stefan-misik/test-board/README.md

# test-board
Simple development board with interface to Nokia 5110 display and matrix keypad and two outputs based on Atmega328 microcontroller
