stefan-misik/test-board/HW/KiCad/ts.kicad_pcb

## KiCad design HW/KiCad/ts.kicad_pcb (2020-12-20)

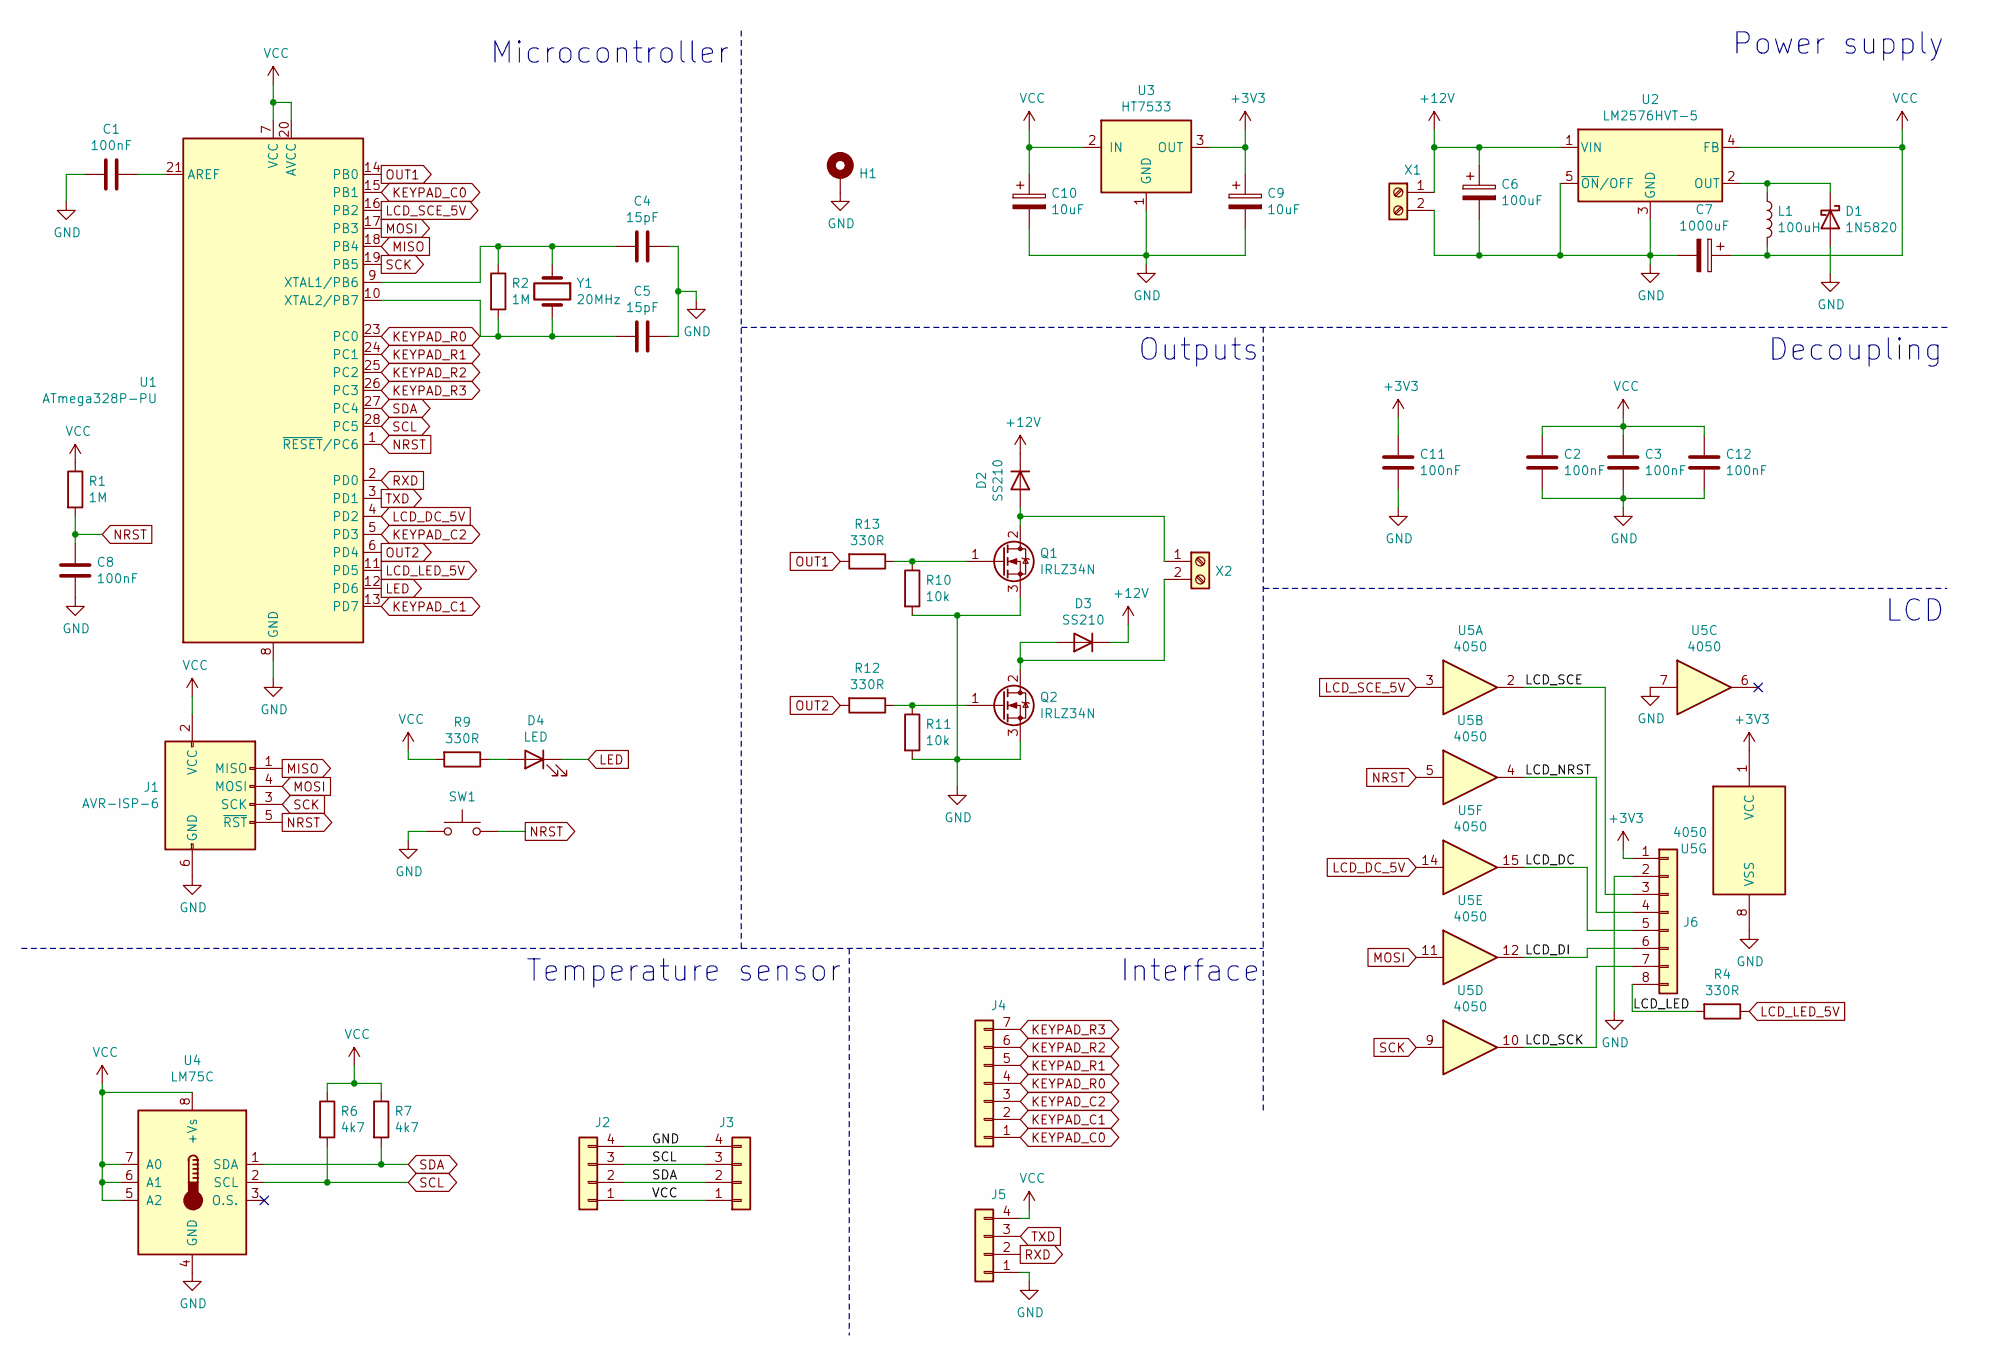
[picture p1: schematic ts.sch, TS board]

Parts:
C1, C2, C3, C8, C11, C12: 100nF; C_0805_2012Metric
C4, C5: 15pF; C_0805_2012Metric
C6: 100uF; CP_Radial_D8.0mm_P3.80mm
C7: 1000uF; CP_Radial_D10.0mm_P5.00mm
C9, C10: 10uF; CP_Elec_5x5.4
D1: 1N5820; D_DO-201AD_P15.24mm_Horizontal
D2, D3: SS210; D_SMB
D4: LED; LED_D5.0mm
H1: MountingHole_Pad; MountingHole_3.5mm_Pad
J1: AVR-ISP-6; PinHeader_2x03_P2.54mm_Vertical
J2, J3, J5: Conn_01x04; PinHeader_1x04_P2.54mm_Vertical
J4: Conn_01x07; PinHeader_1x07_P2.54mm_Vertical
J6: Conn_01x08; PinHeader_1x08_P2.54mm_Vertical
L1: 100uH; L_Toroid_Vertical_L16.4mm_W7.6mm_P6.60mm_Vishay_TJ3
Q1, Q2: IRLZ34N; TO-220-3_Vertical
R1, R2: 1M; R_0805_2012Metric
R4, R9, R12, R13: 330R; R_0805_2012Metric
R6, R7: 4k7; R_0805_2012Metric
R10, R11: 10k; R_0805_2012Metric
SW1: RESET; SW_PUSH_6mm
U1: ATmega328P-PU; DIP-28_W7.62mm_Socket
U2: LM2576HVT-5; TO-220-5_Vertical
U3: HT7533; TO-92
U4: LM75C; SOIC-8_3.9x4.9mm_P1.27mm
U5: 4050; SOIC-16_3.9x9.9mm_P1.27mm
X1, X2: Screw_Terminal_01x02; TerminalBlock_bornier-2_P5.08mm
Y1: 20MHz; Crystal_HC49-4H_Vertical

Connections:
+3V3: C9.1, C11.1, J6.1, U3.3 (OUT), U5.1 (VCC)
+12V: C6.1, D2.1 (K), D3.1 (K), U2.1 (VIN), X1.1
/LCD_DC: J6.5, U5.15
/LCD_DI: J6.6, U5.12
/LCD_LED: J6.8, R4.2
/LCD_NRST: J6.4, U5.4
/LCD_SCE: J6.3, U5.2
/LCD_SCK: J6.7, U5.10
GND: C1.2, C2.2, C3.2, C4.1, C5.1, C6.2, C7.2, C8.1, C9.2, C10.2, C11.2, C12.2, D1.2 (A), H1.1, J1.6 (GND), J2.4, J3.4, J5.1, J6.2, Q1.3 (S), Q2.3 (S), R10.2, R11.2, SW1.1, U1.8 (GND), U1.22 (GND), U2.3 (GND), U2.5 (~ON~/OFF), U3.1 (GND), U4.4 (GND), U5.7, U5.8 (VSS), X1.2
KEYPAD_C0: J4.1, U1.15 (PB1)
KEYPAD_C1: J4.2, U1.13 (PD7)
KEYPAD_C2: J4.3, U1.5 (PD3)
KEYPAD_R0: J4.4, U1.23 (PC0)
KEYPAD_R1: J4.5, U1.24 (PC1)
KEYPAD_R2: J4.6, U1.25 (PC2)
KEYPAD_R3: J4.7, U1.26 (PC3)
LCD_DC_5V: U1.4 (PD2), U5.14
LCD_LED_5V: R4.1, U1.11 (PD5)
LCD_SCE_5V: U1.16 (PB2), U5.3
LED: D4.1 (K), U1.12 (PD6)
MISO: J1.1 (MISO), U1.18 (PB4)
MOSI: J1.4 (MOSI), U1.17 (PB3), U5.11
NRST: C8.2, J1.5 (~RST), R1.2, SW1.2, U1.1 (~RESET~/PC6), U5.5
unnamed: C1.1, U1.21 (AREF)
unnamed: C4.2, R2.1, U1.9 (XTAL1/PB6), Y1.1
unnamed: C5.2, R2.2, U1.10 (XTAL2/PB7), Y1.2
unnamed: D1.1 (K), L1.1, U2.2 (OUT)
unnamed: D2.2 (A), Q1.2 (D), X2.1
unnamed: D3.2 (A), Q2.2 (D), X2.2
unnamed: D4.2 (A), R9.1
unnamed: Q1.1 (G), R10.1, R13.1
unnamed: Q2.1 (G), R11.1, R12.1
OUT1: R13.2, U1.14 (PB0)
OUT2: R12.2, U1.6 (PD4)
RXD: J5.2, U1.2 (PD0)
SCK: J1.3 (SCK), U1.19 (PB5), U5.9
SCL: J2.3, J3.3, R6.2, U1.28 (PC5), U4.2 (SCL)
SDA: J2.2, J3.2, R7.2, U1.27 (PC4), U4.1 (SDA)
TXD: J5.3, U1.3 (PD1)
VCC: C2.1, C3.1, C7.1, C10.1, C12.1, J1.2 (VCC), J2.1, J3.1, J5.4, L1.2, R1.1, R6.1, R7.1, R9.2, U1.7 (VCC), U1.20 (AVCC), U2.4 (FB), U3.2 (IN), U4.5 (A2), U4.6 (A1), U4.7 (A0), U4.8 (+Vs)

Notes on the sheet:
Temperature sensor
Interface
Microcontroller
Power supply
Decoupling
LCD
Outputs

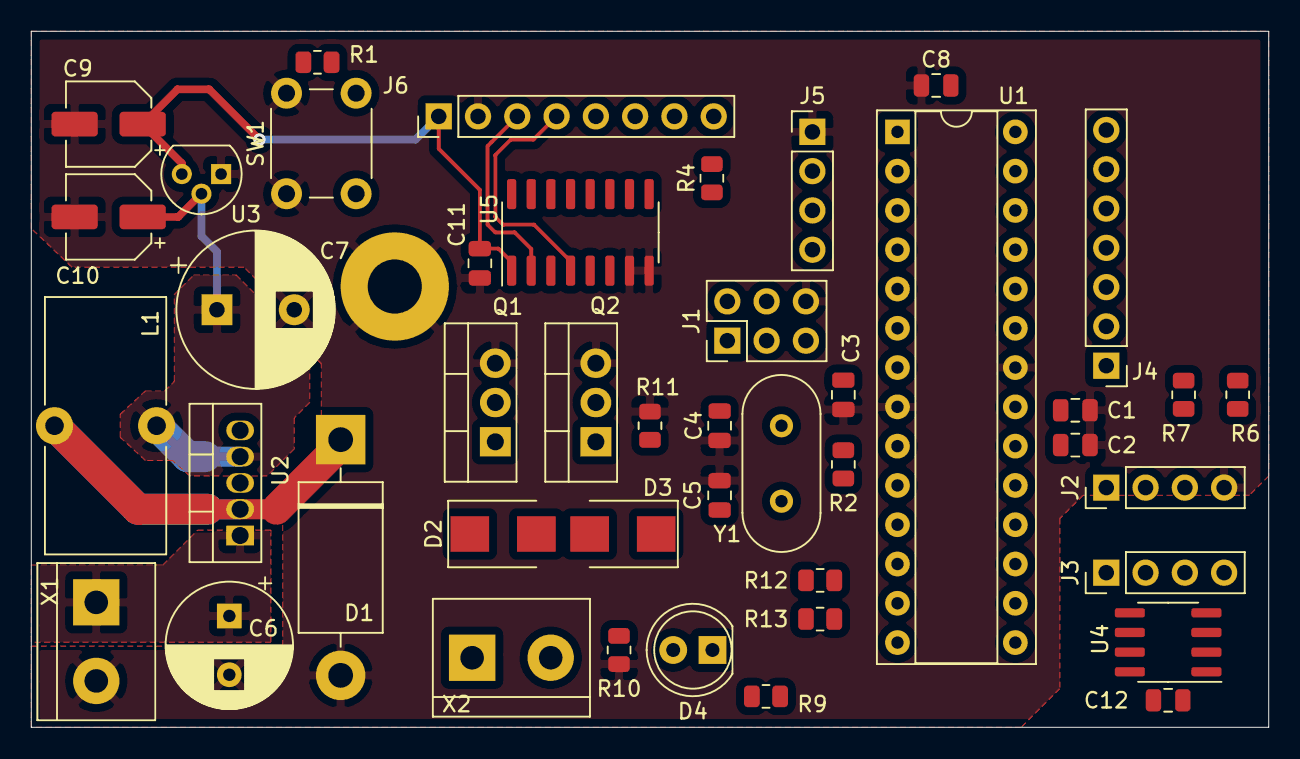
[picture p2: board ts.kicad_pcb from above]

Board: 2 copper layers, 80.0 x 45.0 mm, 45 parts (0 on the bottom side), 40 nets.
