stefan-misik/test-board/HW/Eagle/projects/ts/main.brd

## EAGLE design HW/Eagle/projects/ts/main.brd (2018-11-20)

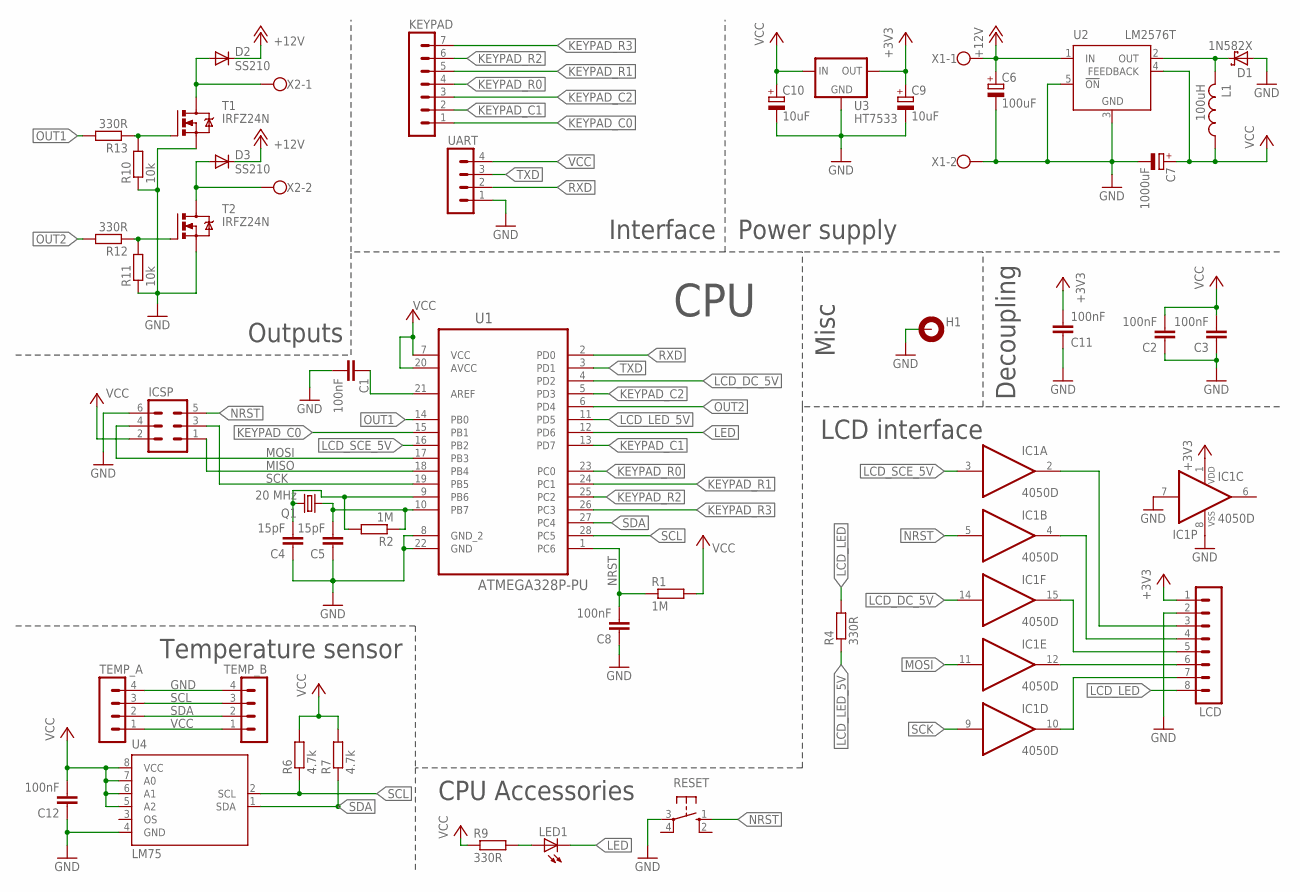
[picture p3: schematic main.sch]

Parts:
C1, C2, C3, C8, C11, C12: 100nF; C0805
C4, C5: 15pF; C0805
C6: 100uF; TAP5-80
C7: 1000uF; TT5D10
C9, C10: 10uF; PANASONIC_C
D1: 1N582X; DIODE5MM
D2, D3: SS210; SMB
H1: MOUNT-PAD-ROUND3.6; 3,6-PAD
IC1: 4050D; SO16
ICSP: MA03-2
KEYPAD: MA07-1
L1: 100uH; TJ3-U1
LCD: MA08-1
LED1: LED5MM
Q1: 20 MHz; HC49/S
R1, R2: 1M; R0805
R4, R9, R12, R13: 330R; R0805
R6, R7: 4.7k; R0805
R10, R11: 10k; R0805
RESET: 10-XX; B3F-10XX
T1, T2: IRFZ24N; TO220AB
TEMP_A: MA04-1
TEMP_B: MA04-1
U1: ATMEGA328P-PU; DIP254P762X457-28
U2: LM2576T; TO220-5
U3: HT7533; TO-92
U4: LM75; SOIC8
UART: MA04-1
X1, X2: W237-102

Connections:
+3V3: C9.+, C11.2, IC1.1 (VDD), LCD.1, U3.3 (OUT)
+12V: C6.+, D2.C, D3.C, U2.1 (IN), X1.1
GND: C1.2, C2.1, C3.1, C4.1, C5.1, C6.-, C7.-, C8.1, C9.-, C10.-, C11.1, C12.1, D1.A, H1.B3,6, IC1.7 (I), IC1.8 (VSS), ICSP.6, LCD.2, R10.1, R11.1, RESET.3, T1.S, T2.S, TEMP_A.4, TEMP_B.4, U1.8 (GND_2), U1.22 (GND), U2.3 (GND), U2.5 (!ON), U3.1 (GND), U4.4 (GND), UART.1, X1.2
KEYPAD_C0: KEYPAD.1, U1.15 (PB1)
KEYPAD_C1: KEYPAD.2, U1.13 (PD7)
KEYPAD_C2: KEYPAD.3, U1.5 (PD3)
KEYPAD_R0: KEYPAD.4, U1.23 (PC0)
KEYPAD_R1: KEYPAD.5, U1.24 (PC1)
KEYPAD_R2: KEYPAD.6, U1.25 (PC2)
KEYPAD_R3: KEYPAD.7, U1.26 (PC3)
LCD_DC: IC1.15 (O), LCD.5
LCD_DC_5V: IC1.14 (I), U1.4 (PD2)
LCD_LED: LCD.8, R4.2
LCD_LED_5V: R4.1, U1.11 (PD5)
LCD_MOSI: IC1.12 (O), LCD.6
LCD_RST: IC1.4 (O), LCD.4
LCD_SCE: IC1.2 (O), LCD.3
LCD_SCE_5V: IC1.3 (I), U1.16 (PB2)
LCD_SCK: IC1.10 (O), LCD.7
LED: LED1.K (C), U1.12 (PD6)
MISO: ICSP.1, U1.18 (PB4)
MOSI: IC1.11 (I), ICSP.4, U1.17 (PB3)
unnamed: C1.1, U1.21 (AREF)
unnamed: C5.2, Q1.1, R2.1, U1.10 (PB7)
unnamed: C4.2, Q1.2, R2.2, U1.9 (PB6)
unnamed: LED1.A, R9.2
unnamed: R10.2, R13.1, T1.G
unnamed: R11.2, R12.1, T2.G
NRST: C8.2, IC1.5 (I), ICSP.5, R1.1, RESET.1 (S), U1.1 (PC6)
OUT1: R13.2, U1.14 (PB0)
OUT1_OC: D2.A, T1.D, X2.1
OUT2: R12.2, U1.6 (PD4)
OUT2_OC: D3.A, T2.D, X2.2
OUT_5V: D1.C, L1.2, U2.2 (OUT)
RXD: U1.2 (PD0), UART.2
SCK: IC1.9 (I), ICSP.3, U1.19 (PB5)
SCL: R6.1, TEMP_A.3, TEMP_B.3, U1.28 (PC5), U4.2 (SCL)
SDA: R7.1, TEMP_A.2, TEMP_B.2, U1.27 (PC4), U4.1 (SDA)
TXD: U1.3 (PD1), UART.3
VCC: C2.2, C3.2, C7.+, C10.+, C12.2, ICSP.2, L1.1, R1.2, R6.2, R7.2, R9.1, TEMP_A.1, TEMP_B.1, U1.7 (VCC), U1.20 (AVCC), U2.4 (FEEDBACK), U3.2 (IN), U4.5 (A2), U4.6 (A1), U4.7 (A0), U4.8 (VCC), UART.4

Notes on the sheet:
Outputs
Temperature sensor
LCD interface
Power supply
Interface
CPU Accessories
Decoupling
Misc
CPU

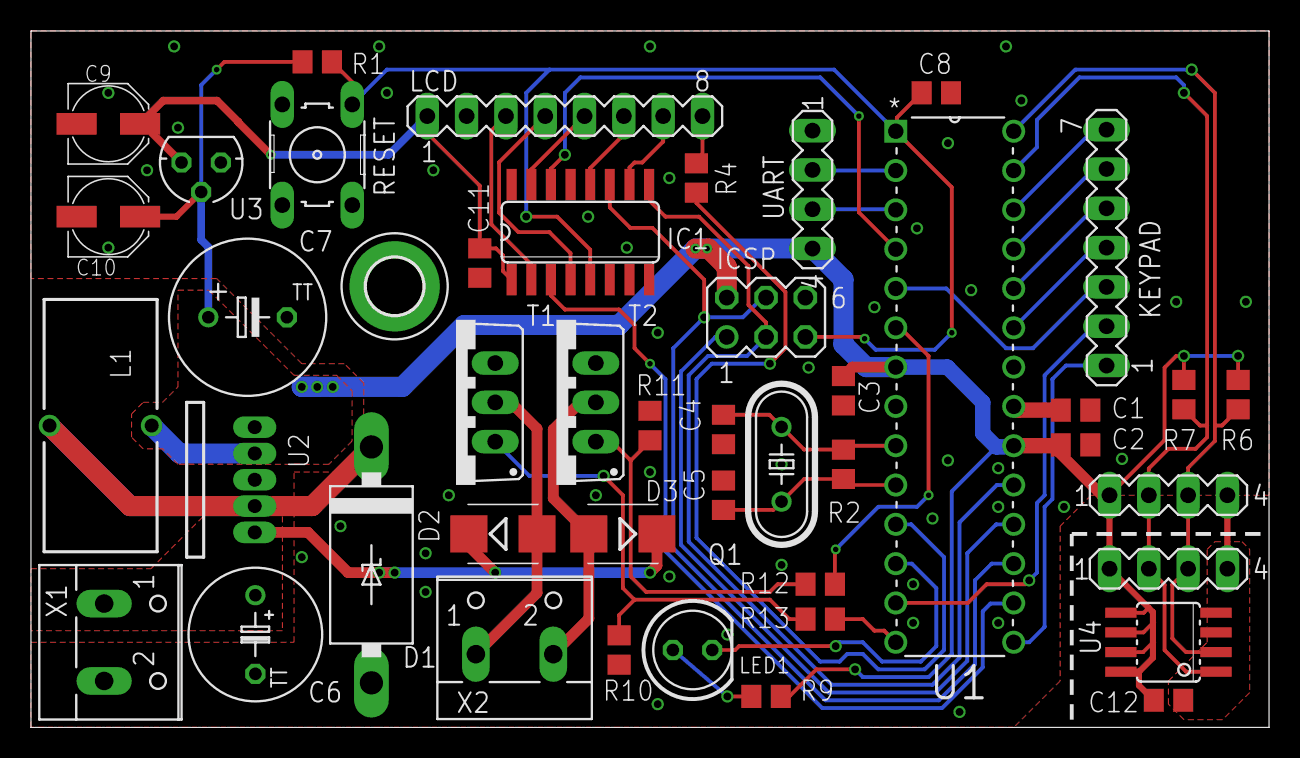
[picture p4: board main.brd from above]

Board: 2 copper layers, 80.0 x 45.0 mm, 45 parts (0 on the bottom side), 40 nets.
