stefan-misik/test-board/SW/embedded/lcd.c

/**
 * \file    lcd.c
 * \author  Stefan Misik
 * \brief   Driver for the LCD
 *     
 */

#include "common.h"
#include "lcd.h"
#include <util/delay.h>
#include <avr/pgmspace.h>
#include <stdio.h>

/**
 * \brief Set lcd mode to DATA
 */
#define lcd_set_d()            PORTD |= (1 << PORTD2)

/**
 * \brief Set lcd mode to COMMAND
 */
#define lcd_set_c()            PORTD &= ~(1 << PORTD2)

/**
 * \brief Set lcd SCE
 */
#define lcd_set_sce(val)    (val) ? (PORTB |= (1 << PORTB2)) : (PORTB &= ~(1 << PORTB2))

/**
 * \brief Macro to calculate display position from coordinates
 */
#define lcd_make_pos(col, row)    ((col) + (84 * (row)))

/**
 * \brief Position on the display 
 */
static unsigned int lcd_pos;


#if LCD_USE_BUFFER == 1

/**
 * \brief Image on the display
 */
unsigned char lcd_buffer[504];

#endif

/**
 * \brief Font
 */
static const unsigned char lcd_ascii[][5] PROGMEM =
{
    {0x00, 0x00, 0x00, 0x00, 0x00}, /* 20   */
    {0x00, 0x00, 0x5f, 0x00, 0x00}, /* 21 ! */
    {0x00, 0x07, 0x00, 0x07, 0x00}, /* 22 " */
    {0x14, 0x7f, 0x14, 0x7f, 0x14}, /* 23 # */
    {0x24, 0x2a, 0x7f, 0x2a, 0x12}, /* 24 $ */
    {0x23, 0x13, 0x08, 0x64, 0x62}, /* 25 % */
    {0x36, 0x49, 0x55, 0x22, 0x50}, /* 26 & */
    {0x00, 0x05, 0x03, 0x00, 0x00}, /* 27 ' */
    {0x00, 0x1c, 0x22, 0x41, 0x00}, /* 28 ( */
    {0x00, 0x41, 0x22, 0x1c, 0x00}, /* 29 ) */
    {0x14, 0x08, 0x3e, 0x08, 0x14}, /* 2a * */
    {0x08, 0x08, 0x3e, 0x08, 0x08}, /* 2b + */
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
    {0x00, 0x00, 0x00, 0x00, 0x00}, /* dd [not implemented] */
    {0x00, 0x00, 0x00, 0x00, 0x00}, /* de [not implemented] */
    {0x00, 0x00, 0x00, 0x00, 0x00}, /* df [not implemented] */
    {0x00, 0x00, 0x00, 0x00, 0x00}, /* e0 [not implemented] */
    {0x00, 0x00, 0x00, 0x00, 0x00}, /* e1 [not implemented] */
    {0x00, 0x00, 0x00, 0x00, 0x00}, /* e2 [not implemented] */
    {0x00, 0x00, 0x00, 0x00, 0x00}, /* e3 [not implemented] */
    {0x00, 0x00, 0x00, 0x00, 0x00}, /* e4 [not implemented] */
    {0x00, 0x00, 0x00, 0x00, 0x00}, /* e5 [not implemented] */
    {0x00, 0x00, 0x00, 0x00, 0x00}, /* e6 [not implemented] */
    {0x00, 0x00, 0x00, 0x00, 0x00}, /* e7 [not implemented] */
    {0x00, 0x00, 0x00, 0x00, 0x00}, /* e8 [not implemented] */
    {0x00, 0x00, 0x00, 0x00, 0x00}, /* e9 [not implemented] */
    {0x00, 0x00, 0x00, 0x00, 0x00}, /* ea [not implemented] */
    {0x00, 0x00, 0x00, 0x00, 0x00}, /* eb [not implemented] */
    {0x00, 0x00, 0x00, 0x00, 0x00}, /* ec [not implemented] */
    {0x00, 0x00, 0x00, 0x00, 0x00}, /* ed [not implemented] */
    {0x00, 0x00, 0x00, 0x00, 0x00}, /* ee [not implemented] */
    {0x00, 0x00, 0x00, 0x00, 0x00}, /* ef [not implemented] */
    {0x00, 0x00, 0x00, 0x00, 0x00}, /* f0 [not implemented] */
    {0x00, 0x00, 0x00, 0x00, 0x00}, /* f1 [not implemented] */
    {0x00, 0x00, 0x00, 0x00, 0x00}, /* f2 [not implemented] */
    {0x00, 0x00, 0x00, 0x00, 0x00}, /* f3 [not implemented] */
    {0x00, 0x00, 0x00, 0x00, 0x00}, /* f4 [not implemented] */
    {0x00, 0x00, 0x00, 0x00, 0x00}, /* f5 [not implemented] */
    {0x00, 0x00, 0x00, 0x00, 0x00}, /* f6 [not implemented] */
    {0x00, 0x00, 0x00, 0x00, 0x00}, /* f7 [not implemented] */
    {0x06, 0x09, 0x09, 0x06, 0x00}, /* f8 ° */
    {0x00, 0x00, 0x00, 0x00, 0x00}, /* f9 [not implemented] */
    {0x00, 0x00, 0x00, 0x00, 0x00}, /* fa [not implemented] */
    {0x00, 0x00, 0x00, 0x00, 0x00}, /* fb [not implemented] */
    {0x00, 0x00, 0x00, 0x00, 0x00}, /* fc [not implemented] */
    {0x00, 0x00, 0x00, 0x00, 0x00}, /* fd [not implemented] */
    {0x00, 0x00, 0x00, 0x00, 0x00}, /* fe [not implemented] */
    {0x00, 0x00, 0x00, 0x00, 0x00}  /* ff [not implemented] */
};

/**
 * \brief Bold flag
 */
static char lcd_fond_bold = 0;

/******************************************************************************/
static int lcd_putchar_fdev(
    char c,
    FILE * fd
)
{
    if(stdout == fd)
    {
        return lcd_putchar((unsigned char)c);
    }
    return 0;
}

/**
 * \brief Output stream to LCD
 * 
 */
static FILE lcd_sout =
    FDEV_SETUP_STREAM(lcd_putchar_fdev, NULL, _FDEV_SETUP_WRITE);

/******************************************************************************/
static void lcd_transmit(
    char data
)
{
    /* Start transmission */
    SPDR = data;
    /* Wait for transmission complete */
    while( !(SPSR & (1 << SPIF)) )
        ;    
}

/******************************************************************************/
static void lcd_set_pos_remote
(
    unsigned char col,
    unsigned char row
)
{
    /* Enable serial interface */
    lcd_set_sce(0);
    /* Set command mode */
    lcd_set_c();
    /* lcd_transmit(0x20); */ /* Basic commands */
    lcd_transmit(0x40 | (row & 0x07)); /* Set Y */
    lcd_transmit(0x80 | (col & 0x7F)); /* Set X */
    
    /* Release serial interface */
    lcd_set_sce(1);
}

/******************************************************************************/
void lcd_init(
    void
)
{
    /* Disable power reduction for SPI */
    PRR &= ~(1 << PRSPI);
    /* Set output direction to LCD DC, SCE, LED pin */
    DDRD |= ( (1 << DDD2) | (1 << DDD4) | (1 << DDD5) );
    /* Set SS pin as output */
    DDRB |= (1 << DDB2);
    
    /* Set MOSI and SCK output, all others input */
    DDRB |= ( (1 << DDB3) | (1 << DDB5) );
    /* DDRB &= ~( (1 << DDB4) ); */
    
    /* Enable SPI, Master, set clock rate fck/8 (double rate) */
    SPCR = ( (1 << SPE) | (1 << MSTR) | (0 << SPR1) | (1 << SPR0) );
	SPSR |= (1 << SPI2X);
    
    
    /* Reset serial interface */
    lcd_set_sce(1);
    
    lcd_set_ex(LCD_VOP, 65);    /* Set LCD Vop (Contrast) */    
    lcd_set_ex(LCD_TC, 0);      /* Set temp coefficient */    
    lcd_set_ex(LCD_BS, 4);      /* LCD bias mode 1:48 */    
    
    /* Enable LCD */
    lcd_set_sce(0);

    /* Switch to COMMAND mode */
    lcd_set_c();
    
    /* Normal operation */
    lcd_transmit(0x0C);

    lcd_set_pos(0, 0);    

    lcd_set_d();
    
    do 
    {
        int i;
        for(i = 0; i < 504; i ++)
        {
            lcd_transmit(0x00);
            
            #if LCD_USE_BUFFER == 1
            lcd_buffer[i] = 0;
            #endif
        }        
    } while (0);        
    
    lcd_set_pos(0, 0);    
    
    lcd_set_sce(1);
    
    /* Register stdout device */
    stdout = &lcd_sout;
}

/******************************************************************************/
void lcd_test(
    void
)
{
    /* Enable LCD */
    lcd_set_sce(0);
        
    /* Switch to COMMAND mode */
    lcd_set_c();
    
    /* All display segments on */
    lcd_transmit(0x09);
    _delay_ms(1000);
    
    /* Normal operation */
    lcd_transmit(0x0C);
    
    lcd_set_sce(1);
}

/******************************************************************************/
void lcd_set_ex(
    lcd_ex_e what,
    unsigned char val
)
{
    static const unsigned char bases[] PROGMEM = {0x04, 0x10, 0x80};
    static const unsigned char masks[] PROGMEM = {0x03, 0x07, 0x7F};
        
    if (what <= LCD_VOP)
    {    
        /* Enable serial interface */
        lcd_set_sce(0);
        /* Set command mode */
        lcd_set_c();
    
        lcd_transmit(0x21); /* Extended commands */
        /* Write command */
        lcd_transmit((pgm_read_byte(bases + what)) | 
            (val & (pgm_read_byte(masks + what))));
        lcd_transmit(0x20); /* Basic commands */
        
        /* Release serial interface */
        lcd_set_sce(1);
    }
}

/******************************************************************************/
void lcd_put(
    const unsigned char * data,
    unsigned int length
)
{    
    unsigned char tmp;
    
    #if LCD_USE_BUFFER != 1
    /* Enable serial interface */
    lcd_set_sce(0);
    /* Set data mode */
    lcd_set_d();
    #endif
    
    while(length > 0 && lcd_pos < 504)
    {
        tmp = *(data++);
        
        /* Store data in LCD buffer, if enabled */
        #if LCD_USE_BUFFER == 1
        lcd_buffer[lcd_pos] = tmp;
        #else
        /* Write on display */
        lcd_transmit(tmp);                
        #endif            
        
        length --;
        lcd_pos ++;
    }
    
    #if LCD_USE_BUFFER != 1
    /* Release serial interface */
    lcd_set_sce(1);
    #endif
}

/******************************************************************************/
void lcd_set_pos(
    unsigned char col,
    unsigned char row
)
{
    if(col > 83)
    {
        col %= 84;
    }
        
    if(row > 5)
    {
        row %= 6;
    }    
    
    /* Set position on LCD */
    lcd_set_pos_remote(col, row);    
    
    /* Store local position information */    
    lcd_pos = lcd_make_pos(col, row);    
}

#if LCD_USE_BUFFER == 1

/******************************************************************************/
void lcd_invalidate_rect(
    unsigned char left,
    unsigned char top,
    unsigned char right,
    unsigned char bottom
)
{
    char row, col;
    unsigned int new_pos;

	/* Translate points to rows */
	top >>= 3;
	bottom >>=3;
    
    for(row = top; row <= bottom; row++)
    {
        /* Set new position */
        lcd_set_pos(left, row);
        
        /* Enable serial interface */
        lcd_set_sce(0);
        /* Set data mode */
        lcd_set_d();
        
        for(col = left; col <= right; col++)
        {
            lcd_transmit(lcd_buffer[lcd_pos++]);
        }
        
        /* Release serial interface */
        lcd_set_sce(1);
    }        
}

/******************************************************************************/
void lcd_set_point(
    unsigned char x,
    unsigned char y,
    char state
)
{
    if(x < 84 && y < 48)
    {
        if(state)
            lcd_buffer[lcd_make_pos(x, (y >> 3))] |= (1 << (y & 0x07));
        else
            lcd_buffer[lcd_make_pos(x, (y >> 3))] &= ~(1 << (y & 0x07));
            
    }    
}

/******************************************************************************/
char lcd_get_point(
    unsigned char x,
    unsigned char y
)
{
    char point = 0;
    
    if(x < 84 && y < 48)
    {        
        point = (0 != (lcd_buffer[lcd_make_pos(x, (y >> 3))] 
            & (1 << (y & 0x07))));        
    }
    
    return point;
}

#endif

/******************************************************************************/
int lcd_putchar(
    unsigned char c
)
{
    unsigned char i, last_b, current_b;
    static unsigned char tmp[7]; 
    
    /* Enable serial interface */
    lcd_set_sce(0);
    /* Set data mode */
    lcd_set_d();
    
    /* Prepare character identification */
    c -= 0x20;
    if(c >= (int)(sizeof(lcd_ascii) / sizeof(lcd_ascii[0])))
    {
        c = 0;
    }
    
    /* Prepare character to be drawn */
    last_b = 0;
    for(i = 0; i < 5; i ++)
    {
        current_b = pgm_read_byte(&(lcd_ascii[c][i]));
        tmp[i] = current_b | last_b;
        
        if(lcd_fond_bold)
        {
            last_b = current_b;
        }
    }
    
    if(lcd_fond_bold)
    {
        tmp[i++] = last_b;
    }
    
    tmp[i++] = 0;    
    
    /* Draw character */
    lcd_put(tmp, i);
    
    
    /* Release serial interface */
    lcd_set_sce(1);
    
    return c + 0x20;
}

/******************************************************************************/
void lcd_bold(
    char b
)
{
    lcd_fond_bold = (b) ? 1 : 0;
}
