stefan-misik/test-board/SW/tools/graphTest/resource.h

//{{NO_DEPENDENCIES}}
// Microsoft Visual C++ generated include file.
// Used by graphTest.rc
//
#define IDD_MAIN_WND                    101
#define IDC_CUSTOM1                     1001
#define IDC_DISPLAY                     1001

// Next default values for new objects
// 
#ifdef APSTUDIO_INVOKED
#ifndef APSTUDIO_READONLY_SYMBOLS
#define _APS_NEXT_RESOURCE_VALUE        102
#define _APS_NEXT_COMMAND_VALUE         40001
#define _APS_NEXT_CONTROL_VALUE         1002
#define _APS_NEXT_SYMED_VALUE           101
#endif
#endif
