stefan-misik/test-board/(commit log)

2015-01-07 Eagle description files, Design rules for iteadstudio
    [main.brd, main.sch]
2015-01-07 Designed power supply
    [main.brd, main.sch]
2015-01-08 3.3v supply
    [main.brd, main.sch]
2015-01-08 v-regulators library
2015-01-08 Added level shifter CMOS 4050
    [main.brd, main.sch]
2015-01-08 Many changes
    [main.brd, main.sch]
2015-01-08 Moved power pins of 4050
    [main.sch]
2015-01-08 Resized analog ground
    [main.brd]
2015-01-08 Commit before changing to digital temperature sensor
    [main.brd, main.sch]
2015-01-09 Big Update
    [main.brd, main.sch]
2015-01-09 Swaped LCD_SCE_5V and LCD_DC_5V signals on 4050
    [main.brd, main.sch]
2015-01-09 Added Power CMOS transistors
    [main.brd, main.sch]
2015-01-10 HW Release 1
    [main.brd, main.sch]
2015-01-10 Minor HW changes
    [main.brd, main.sch]
2015-01-10 Timer 1 is no longer used for PWM
    [main.brd, main.sch]
2015-01-10 Minor HW Updates
    [main.brd]
2015-01-10 Preparing Gerber files
    [main.GBL, main.GBO, main.GBP, main.GBS, main.GTL, main.GTO, main.GTP, main.GTS]
2015-01-10 Generated final version of gerber files
    [main.brd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]
2015-01-15 Added filters into visual studio project
2015-01-19 Added value of crystal
    [main.brd, main.sch]
2015-01-19 Created BOM file
    [bom.csv]
2015-01-19 Added order numbers in bom.csv
    [bom.csv]
2015-01-26 Added PCB images
2015-01-26 Modified PCB images
2015-02-01 Changed diameters of vias
    [main.brd]
2015-02-01 Changed faulty size of via
    [main.brd]
2015-03-31 Added lcd driver files
2015-03-31 Added SPI communication
2015-04-02 Added temperature sensor driver
2015-04-02 Simple temperature meter
2015-04-03 LCD backlight and LED controlled by PWM
2015-04-03 Replaced inefective modulus operations
    [lcd.c]
2015-04-03 Temperature resolution changed to quarter of dg
2015-04-08 Added timer module
2015-04-10 Replaced R1 due to improper LCD reset procedure
    [main.brd, main.sch]
2015-04-17 Temperature is read using interrupts
2015-04-18 Temperature measurement made more fail-proof
    [temperature.c]
2015-04-20 Added function to check status of temperature measurement
2015-04-21 Tabs replaced with spaces
    [lcd.c, lcd.h, main.c, outputs.c, outputs.h, temperature.c, temperature.h, timer.c]
2015-04-21 Added some alarm functionality to timer module
2017-12-09 [SW] Minor changes in LCD, added keypad
    Added correct stdio putchar function for LCD. Added keypad source files.
    [keypad.c, keypad.h, lcd.c, main.c]
2017-12-12 [HW] Updated PCB
    Fixed keypad connection. Removed copper from underneath the temperature
    sensor. Made temperature sensor removable.
    [main.brd, main.sch]
2017-12-13 [SW] Fixed LCD redraw
    [alarm.c, alarm.h, common.h, lcd.c, lcd.h, main.c, outputs.c, outputs.h]
2017-12-13 [HW] LCD chip select
    Using NSS microcontroller output to drive LCD chip select.
    [main.brd, main.sch]
2017-12-15 [SW] Fixed SPI clock speed for LCD
    [lcd.c]
2017-12-15 [SW] Updated keypad driver
2017-12-20 [HW] Minor modifications
    [main.brd]
2017-12-21 [HW] Removed some parts, updated layout
    Removed unessential parts (0 Ohm resistor, reset pin protection diode).
    Optimized layout to optimize some connections.
    [main.brd, main.sch]
2018-01-02 [HW] Minor change
    [main.brd, main.sch]
2018-04-14 [HW] Organized schematics
    [main.brd, main.sch]
2018-11-20 [HW] Resolved some design DRC and ERC warnings
    [main.brd, main.sch]
2018-11-25 [HW] Removed old gerber files
    [main.GBL, main.GBO, main.GBP, main.GBS, main.GTL, main.GTO, main.GTP, main.GTS]
2018-12-15 [HW] Added KiCad project with schematics
    [ts.kicad_pcb, ts.sch]
2018-12-16 [HW] Fixed issues in the KiCad schematics
    Fixed some footprints associations, 4050 buffer power supply.
    [ts.sch]
2018-12-18 [SW] Basic keypad driver
2020-11-11 [SW] Add fuses programming
2020-12-18 [HW] Place KiCad layout components
    [ts.kicad_pcb, ts.sch]
2020-12-20 [HW] Add some layout
    [ts.kicad_pcb]
